DinethH/Smart-Lamp/README.md

# # Smart Lamp/Sunrise Lamp

<a href="http://www.youtube.com/watch?feature=player_embedded&v=bcLRLUIvyWE
" target="_blank">IMAGE ALT TEXT HERE</a>

https://www.youtube.com/watch?v=bcLRLUIvyWE
