DinethH/Smart-Lamp/(list of files, drawings)

Other design files:
Smart Lamp.pcb
